Boldtkai/ECE411_Team6_Practicum/Enclosure Files/Printed_Lid_Top.jpg

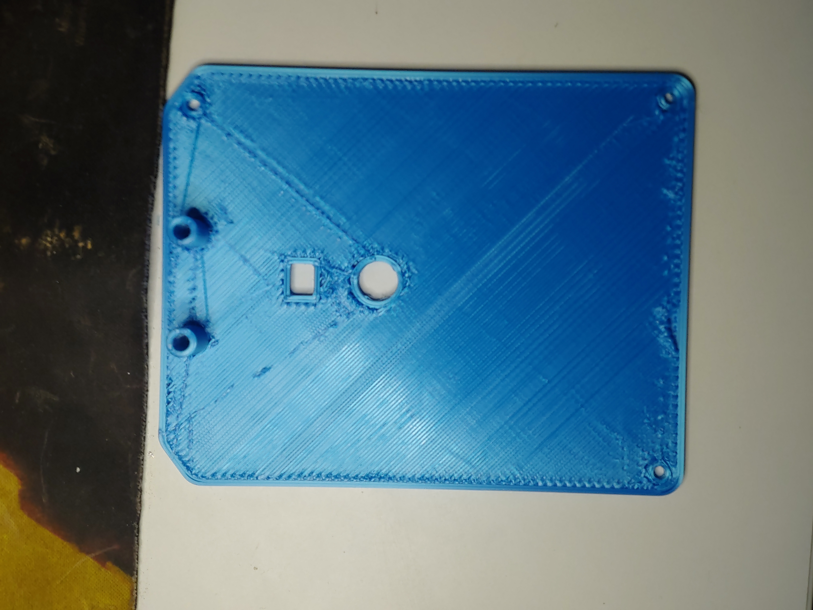
Enclosure Files/Printed_Lid_Top.jpg
