Boldtkai/ECE411_Team6_Practicum/Enclosure Files/Printed_Enclosure.jpg

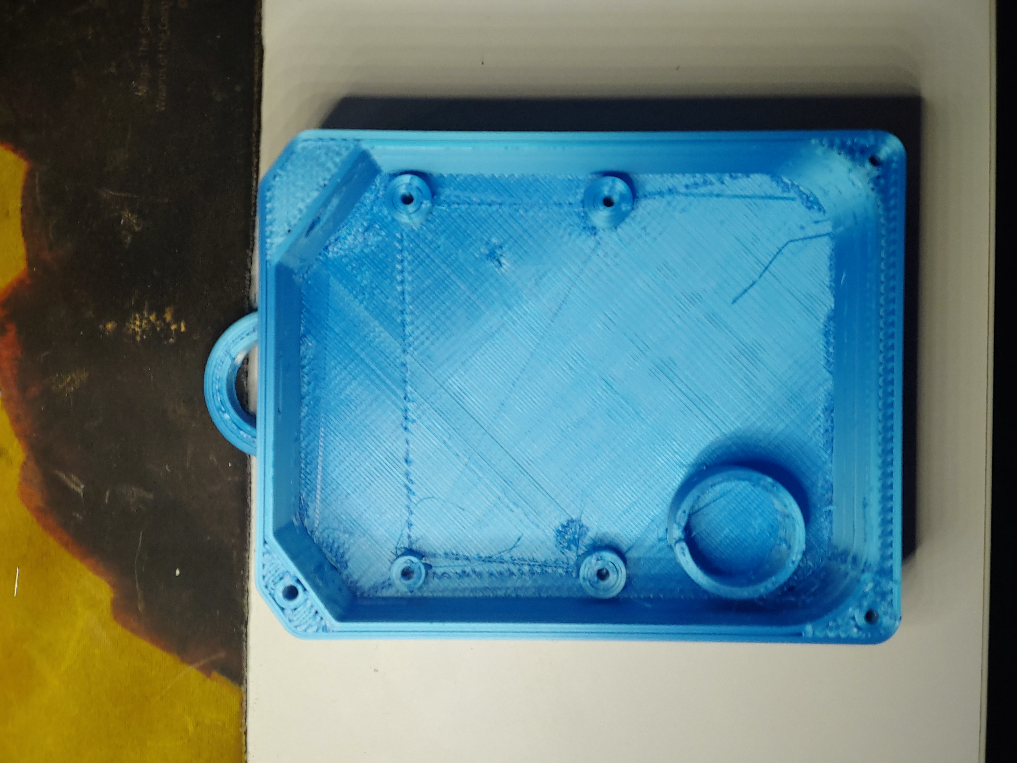
Enclosure Files/Printed_Enclosure.jpg
