Boldtkai/ECE411_Team6_Practicum/Bread Board Prototype/Audio_Amplifier_-_SD_Card_Module.jpg

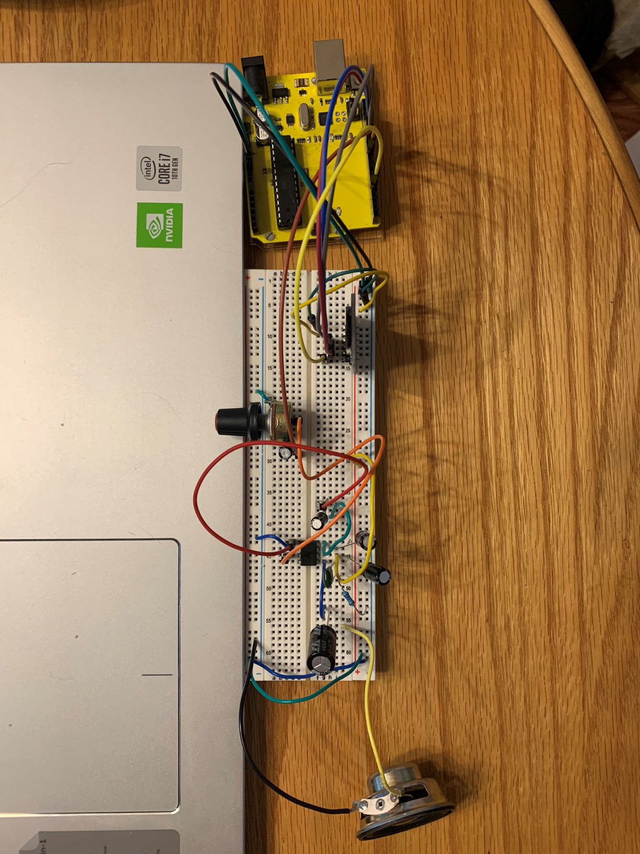
Bread Board Prototype/Audio_Amplifier_-_SD_Card_Module.jpg
