Boldtkai/ECE411_Team6_Practicum/Bread Board Prototype/FInalized Prototype.jpg

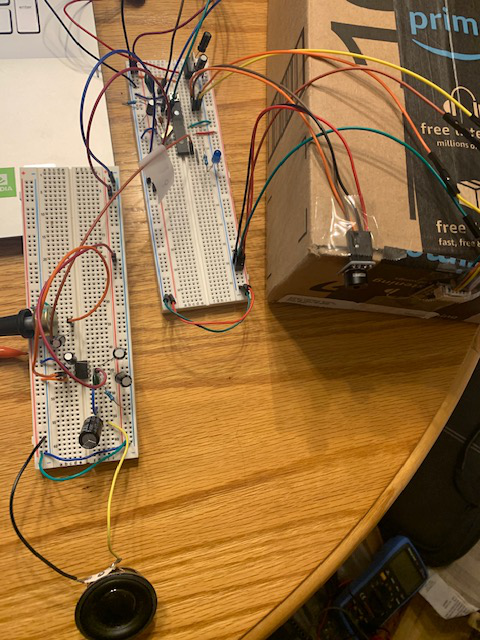
Bread Board Prototype/FInalized Prototype.jpg
