Boldtkai/ECE411_Team6_Practicum/Bread Board Prototype/Input_Sensors.jpg

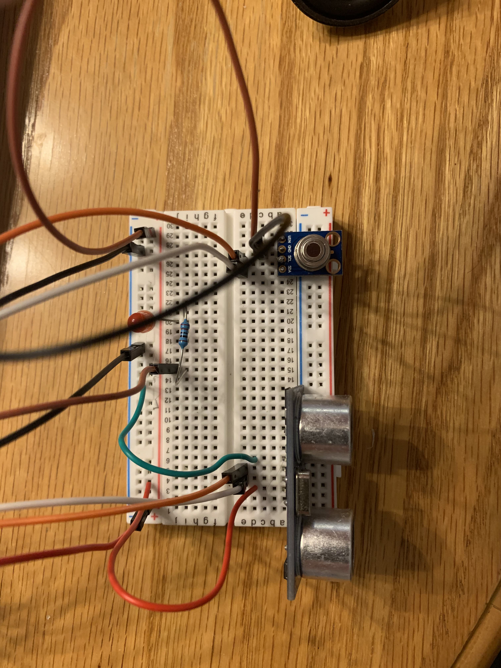
Bread Board Prototype/Input_Sensors.jpg
