Boldtkai/ECE411_Team6_Practicum/Bread Board Prototype/TOF and IR Temperature Sensor.jpg

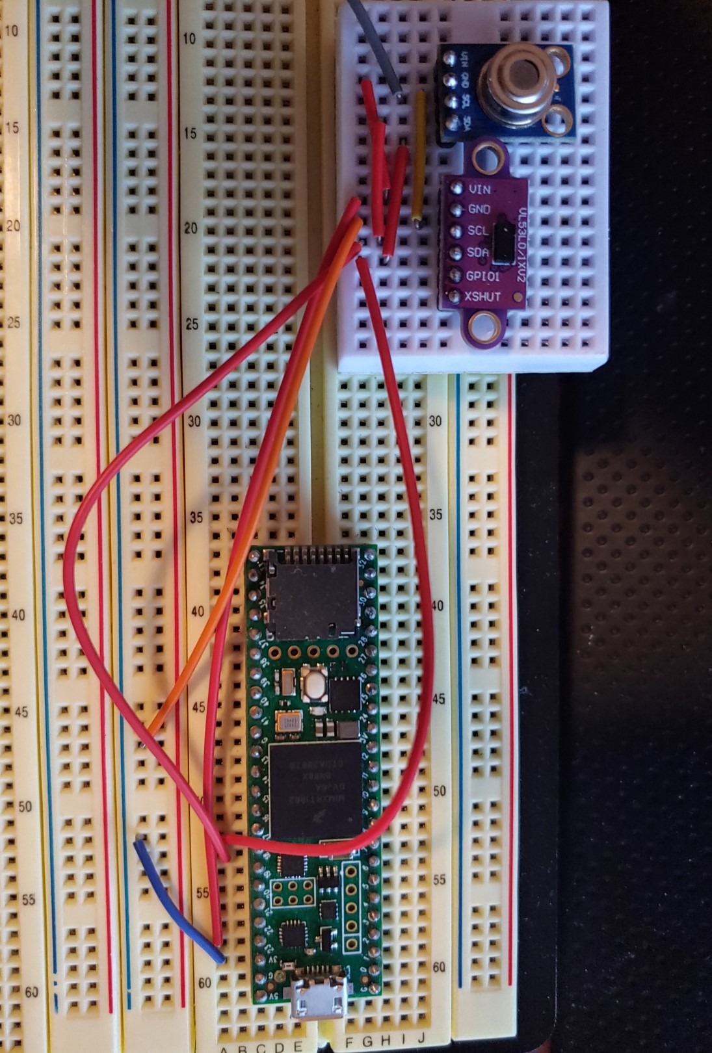
Bread Board Prototype/TOF and IR Temperature Sensor.jpg
