Boldtkai/ECE411_Team6_Practicum/Enclosure Files/Full Enclosure.png

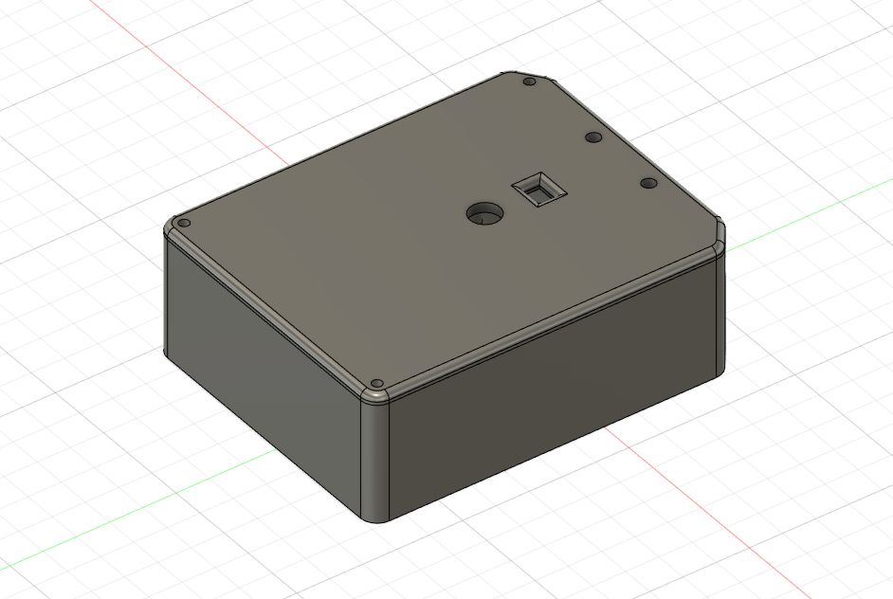
Enclosure Files/Full Enclosure.png
