Boldtkai/ECE411_Team6_Practicum/Enclosure Files/Just box.png

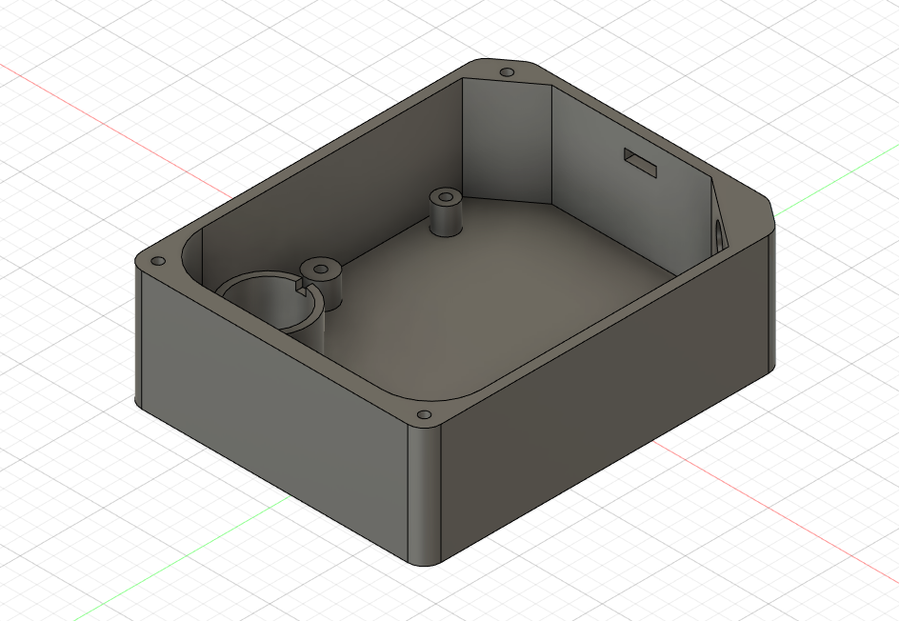
Enclosure Files/Just box.png
