Boldtkai/ECE411_Team6_Practicum/Enclosure Files/Just lid.png

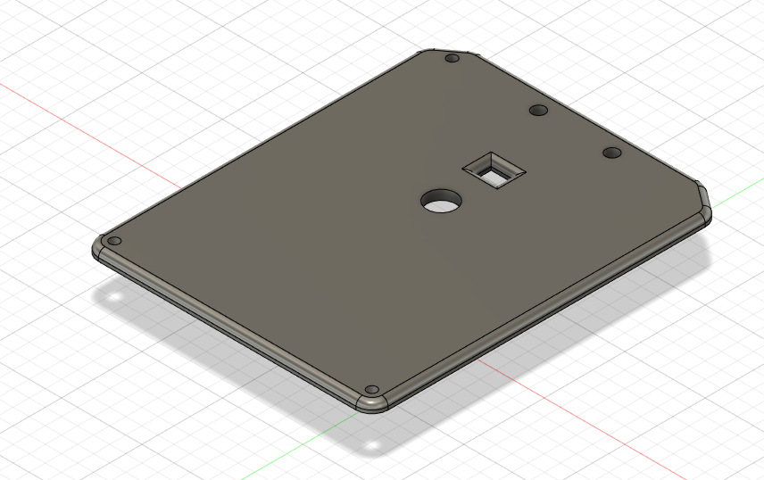
Enclosure Files/Just lid.png
