Boldtkai/ECE411_Team6_Practicum/Enclosure Files/Topdown_box.png

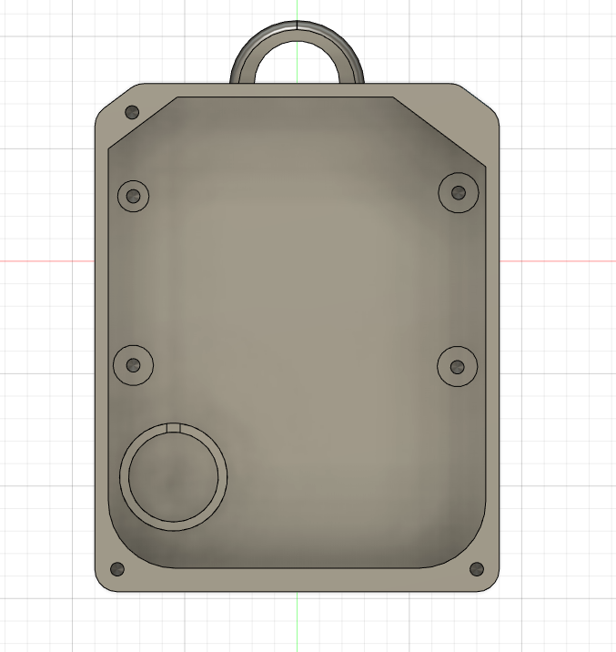
Enclosure Files/Topdown_box.png
