Boldtkai/ECE411_Team6_Practicum/Final Schematic and Layout/ECE411 Final Board Layout.PNG

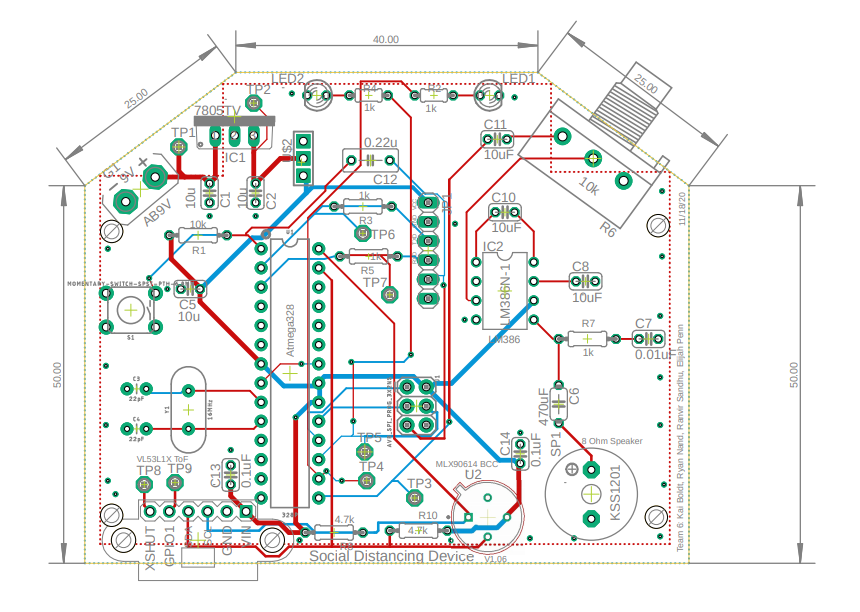
Final Schematic and Layout/ECE411 Final Board Layout.PNG
