Boldtkai/ECE411_Team6_Practicum/Final Schematic and Layout/OSHpark_PCB.jpg

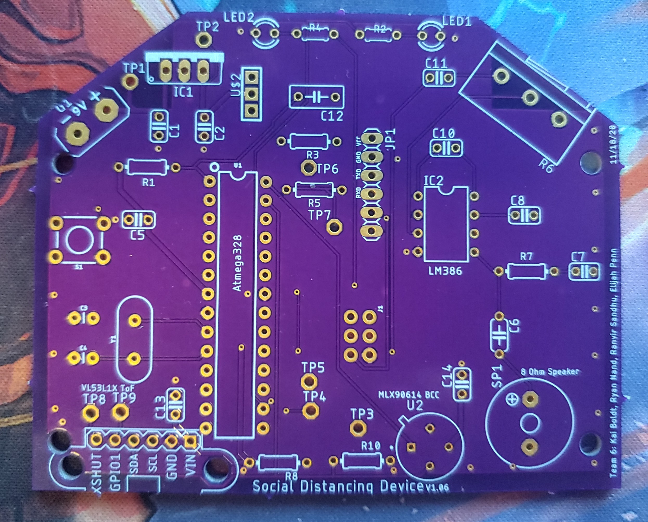
Final Schematic and Layout/OSHpark_PCB.jpg
