Boldtkai/ECE411_Team6_Practicum/Schematics/ECE411 Preliminary Schematic V1.01.png

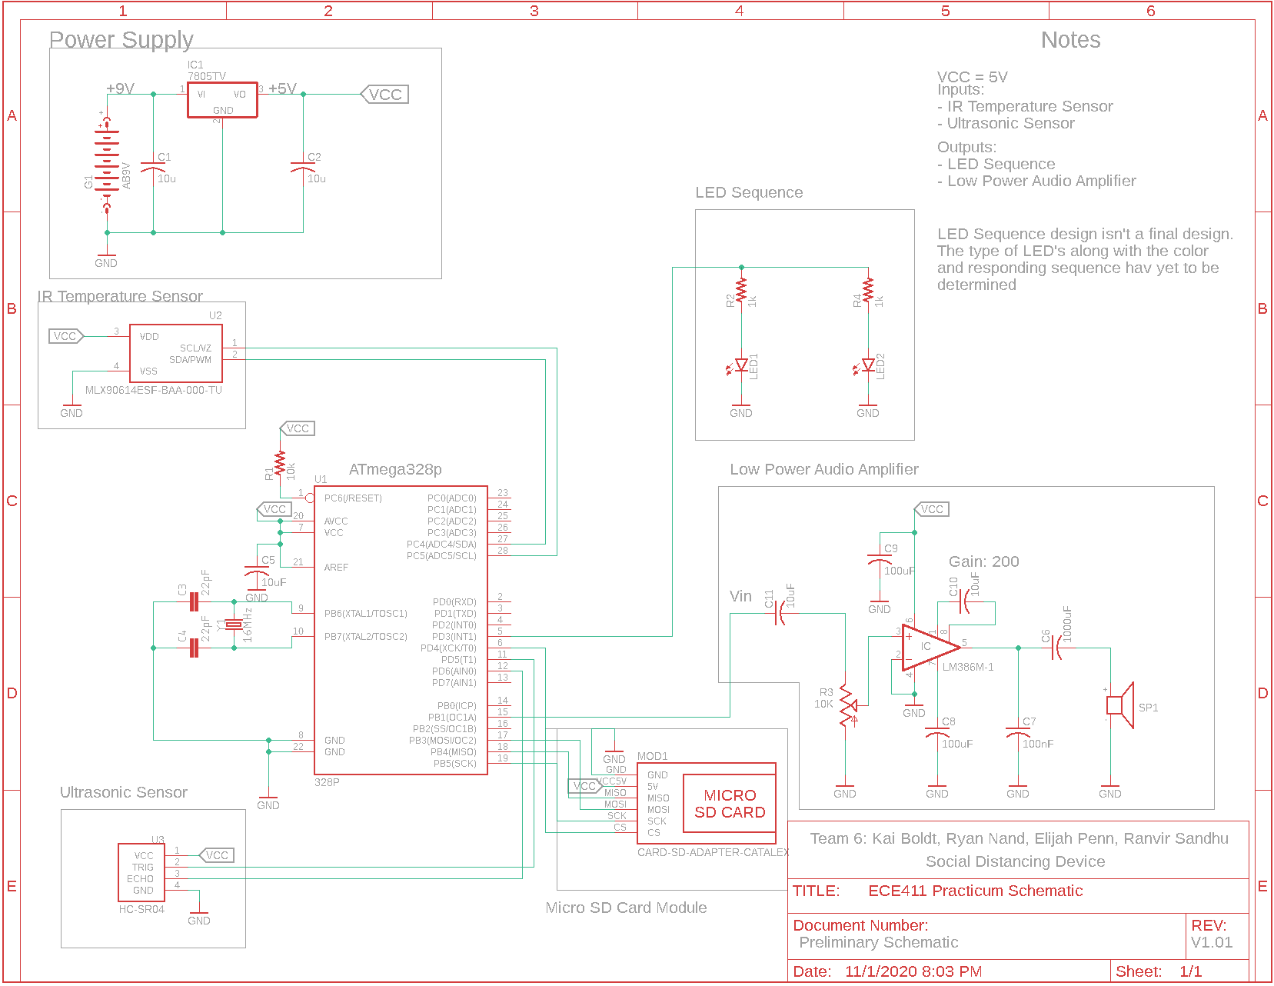
Schematics/ECE411 Preliminary Schematic V1.01.png
