Boldtkai/ECE411_Team6_Practicum/Bill of Materials/ECE411, Team6 - Bill of Materials (BoM).xlsx

Bill of Materials |  | Team 6: Kai Boldt, Ryan Nand, Ranvir Sandhu, Elijah Penn
Generated 11/10/2020
Modified 11/11/2020
Cnt | Value | Refs | Rev | Manufacturer | Mfr.Part Number | Description | Vendor | Vendor-PN | Price($)
2 |  | LED1, LED2 | 1.1 | Lite-On Inc. | LTL-1CHEE | 3mm LED RED CLEAR T/H | Digikey | 160-1704-ND | 0.32
1 | 10KΩ | R6 | 1.1 | TT Electronics | P164K101PNN20B103 | 17mm ROTARY POTENTIOMETER | Digikey | 987-P164K101PNN20B103-N | 1.14
1 | 10KΩ | R1 |  | Xicon | 283-10K-RC | RES 10K OHM 5% AXIAL | Digikey | 2197-283-10K-RC-ND | 0.6
4 | 1KΩ | R2,R3,R4,R5 |  | Xicon | 283-1K-RC | RES 1K OHM 5% AXIAL | Digikey | 2197-283-1K-RC-ND | 0.26
1 | 16MHz | Y1 |  | TXC CORPORATION | 9B-10.000MBBK-B | CRYSTAL 10.0000MHZ 20PF TH | Digikey | 9B-10.000MBBK-B | 0.3
1 | 32kb | U1 |  | Microchip Technology/Atmel | ATMEGA328P-PU | 8-bit Microcontrollers - MCU 32KB In-system Flash 20MHz 1.8V-5.5V | Mouser | 556-ATMEGA328P-PU | 2.08
1 |  | IC1 |  | Texas Instrument | LM7805CT/NOPB | IC REG LINEAR 5V 1A TO220-3 | Digikey | 296-47192-ND | 1.54
1 | 8Ω | SP1 | 1.1 | Kingstate | KSS-1201-16 | MAGNETIC TRANSDUCER
1 |  | IC | 1.1 | Texas Instrument | LM386N-1/NOPB | IC AMP CLASS AB MONO 325mW 8DIP | Digikey | 296-44414-5-ND | 1.17
1 |  | U2 |  | Melexis Technologies NV | MLX90614 BCC | SENSOR DGTL -40C-85C TO39 | Digikey | MLX90614ESF-BCC-000-TU-ND | 24.58
1 |  | U3 | 1.1 | YRCHENGLI | B08KS2X15K | VL53L1X Laser Ranging Flight Time Sensor Module | Amazon |  | 16.19
1 | 9V | G1 |  | Energizer Battery Company | EN22 | 9V Battery Non-Rechargeable | Digikey | N145-ND | 2.13
1 | 1000 µF | C6 |  | Illinois Capacitor | 108CKE025M | CAP ALUM 1000UF 20% 25V RADIAL | Digikey | 1572-1054-ND | 0.73
1 | 0.1 µF | C7 |  | TDK | FG26C0G2A104JRT06 | Multilayer Ceramic Capacitor 100V 0.1uF LS:5mm | Mouser | 810-FG26C0G2A104JRT6 | 1.06
2 | 100 µF | C8,C9 |  | Illinois Capacitor | 107CKE025MEM | CAP ALUM 100UF 20% 25V RADIAL | Digikey | 1572-1039-ND | 0.25
2 | 10 µF | C1,C2 |  | Illinois Capacitor | 106CKH050M | CAP ALUM 10UF 20% 50V THRU HOLE | Digikey | 1572-1284-ND | 0.21
2 | 10 µF | C10,C11 |  | Illinois Crapacito | 106BPS050M | CAP ALUM 10UF 20% 50V RADIAL | Digikey | 1572-1645-ND | 0.31
1 | 10 µF | C5 |  | Illinois Capacitor | ESH106M050AC3AA | CAP ALUM 10UF 20% 50V RADIAL | Digikey | 399-6543-ND | 0.18
2 | 22pF | C3,C4 |  | KEMET | C315C220K2G5TA7301 | CAP CER 22PF 200V C0G/NP0 RADIAL | Digikey | 399-13930-2-ND | 0.31
1 |  |  | 1.1 | HiLetgo | 3-01-0038-5PCS | Micro SD Card Adapter Module 6Pin, SPI Interface Driver Module | Amazon |  | 1.4
1 |  |  | 1.1 | DSD Tech | B07BBPX8B8 | USB to TTL Serial Adapter with FTDI FT232RL Chip | Amazon |  | 9.99
1 | 8Ω | SP1 | 1.1 | Uxcell | a15080600ux0275 | Metal Shell Round Speaker 2W 8 Ohm | Amazon |  | 2.37
NOTES
 | 1. Rev = The current Revision #
2. For Small Components (Resistors and Capacitors) are similar in values to the ones used in project
