Boldtkai/ECE411_Team6_Practicum/Bill of Materials/Bill of Matierials (BoM) V1.02.PNG

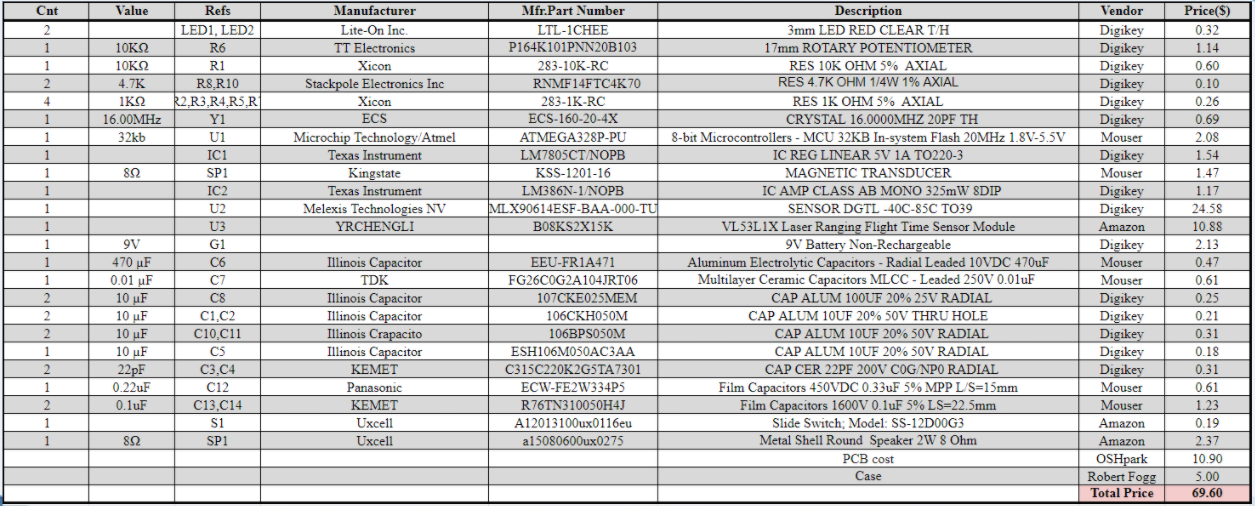
Bill of Materials/Bill of Matierials (BoM) V1.02.PNG
