Boldtkai/ECE411_Team6_Practicum/Enclosure Files/lid.stl

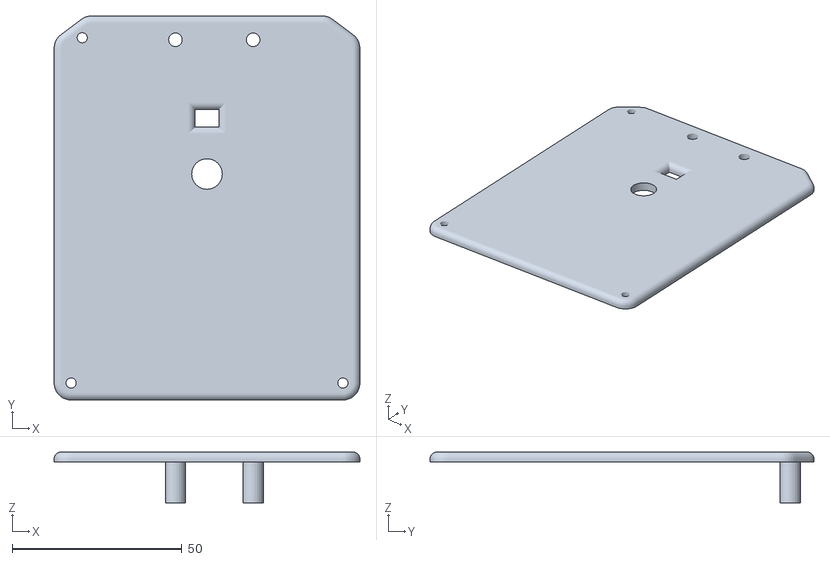
[picture p27: CAD file, 2020-12-05]
Enclosure Files/lid.stl
90.0 x 113.0 x 15.0
