Boldtkai/ECE411_Team6_Practicum/Enclosure Files/Enclosure.stl

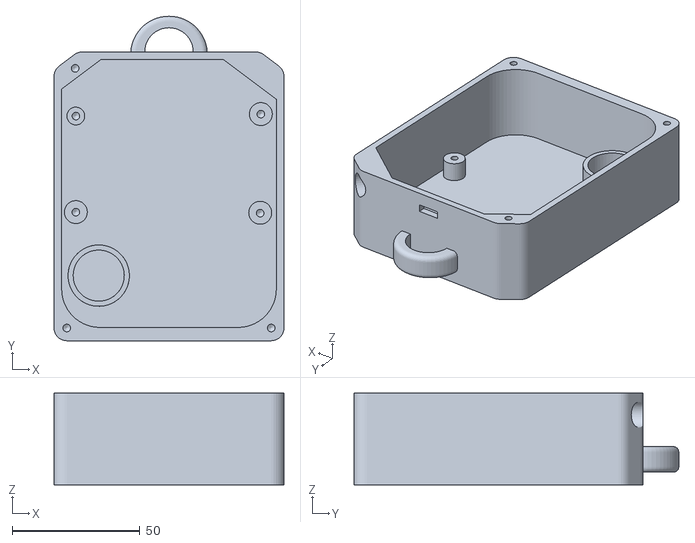
[picture p28: CAD file, 2020-12-05]
Enclosure Files/Enclosure.stl
90.0 x 127.0 x 36.0
