Boldtkai/ECE411_Team6_Practicum/Enclosure Files/Printed_Lid_Bottom.jpg

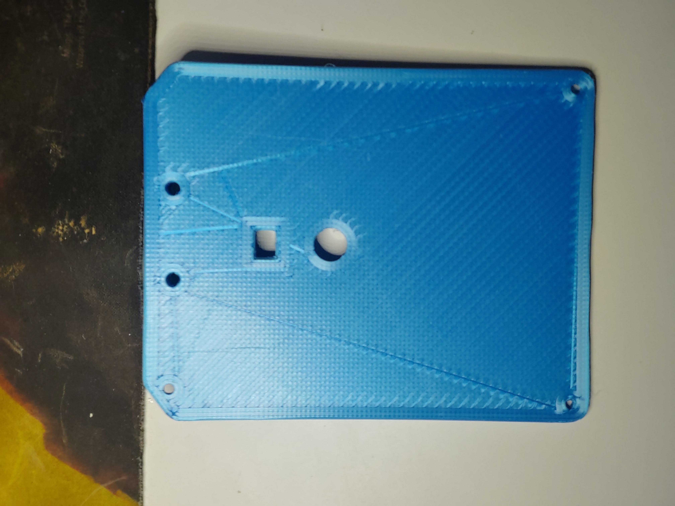
Enclosure Files/Printed_Lid_Bottom.jpg
