Boldtkai/ECE411_Team6_Practicum/(threads)

Thread 2 (2020-11-01):

ESP-NOW:

GenPen, 2020-11-01:
Will test with ESP-now protocol to connect two ESP32 breakout boards in order to have them communicate with each.  The protocol may be used track distance between the two ESP32 breakout boards as an alteranitve to our current set up using an IR and ultrasonic sensor to detect a person.

GenPen, 2020-11-05:
ESP-now can be used to have up to 10 esp32 chips communicate with each other without the need for a wifi network. This could useful if we decide to go with a closed system where the social distances sensors talk to each or instead of sensing the person wearing the device. This could be useful for a potential contact tracing feature later down the line. Using ESP-now to explicitly measure distance will not work.

Closed 2020-12-06.
