Boldtkai/ECE411_Team6_Practicum/Schematics/ECE411 Rough Draft Board Diagram.pdf

# Social Distancing Device

# 10uF 1000uF

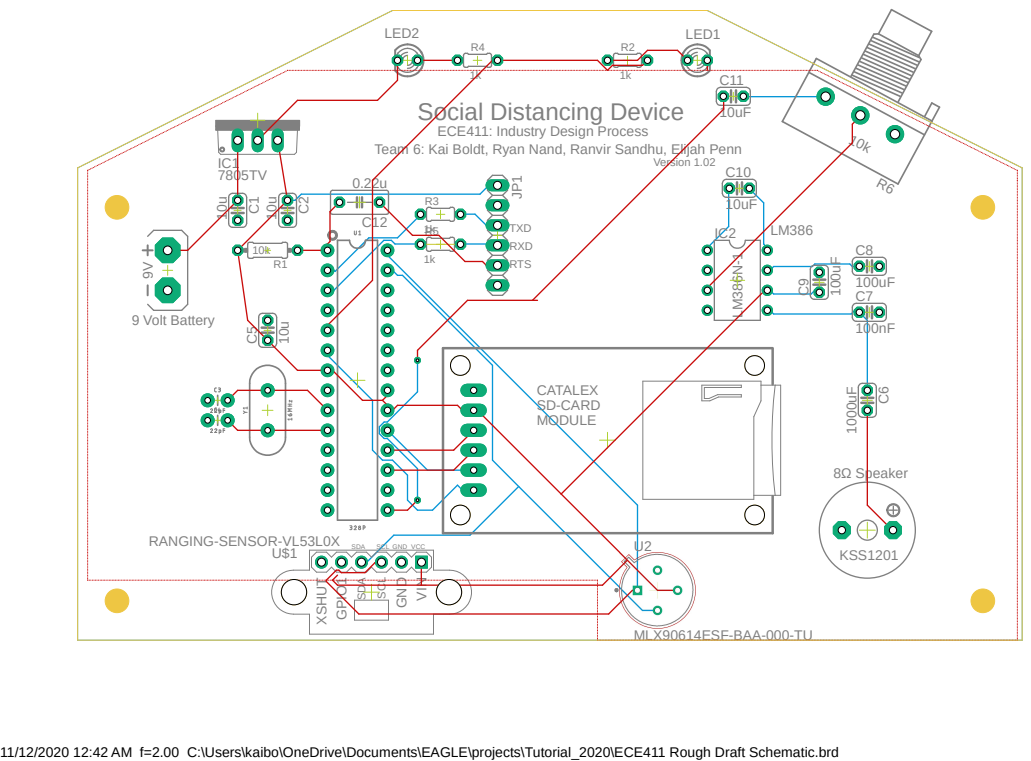
[picture p30: page 1]

Team 6: Kai Boldt, Ryan Nand, Ranvir Sandhu, Elijah Penn

11/12/2020 12:42 AM f=2.00 C:\Users\kaibo\OneDrive\Documents\EAGLE\projects\Tutorial_2020\ECE411 Rough Draft Schematic.brd
