Boldtkai/ECE411_Team6_Practicum/Schematics/ECE411 Rough Draft Schematic Diagram.pdf

## Power Supply

## Notes

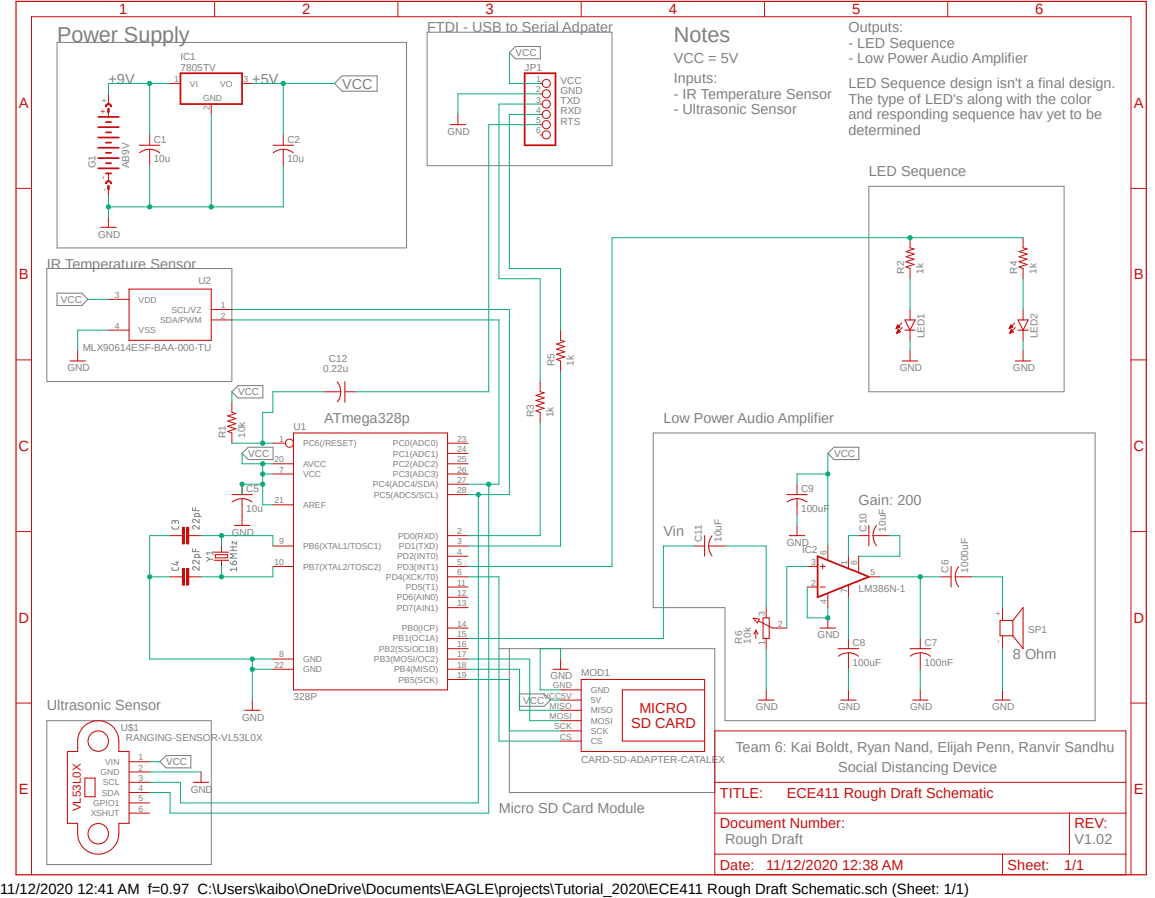
[picture p31: page 1]

FTDI - USB to Serial Adpater

Outputs:
- LED Sequence
- Low Power Audio Amplifier
LED Sequence design isn't a final design.
The type of LED's along with the color
and responding sequence hav yet to be
determined

Low Power Audio Amplifier

Team 6: Kai Boldt, Ryan Nand, Elijah Penn, Ranvir Sandhu

CARD-SD-ADAPTER-CATALEX

Micro SD Card Module

Document Number: | REV:

Date: 11/12/2020 12:38 AM | Sheet: 1/1

11/12/2020 12:41 AM f=0.97 C:\Users\kaibo\OneDrive\Documents\EAGLE\projects\Tutorial_2020\ECE411 Rough Draft Schematic.sch (Sheet: 1/1)
