Boldtkai/ECE411_Team6_Practicum/Schematics/ECE411, Team 6 Preliminary Layout.pdf

# Social Distancing Device

# C11 C⁶

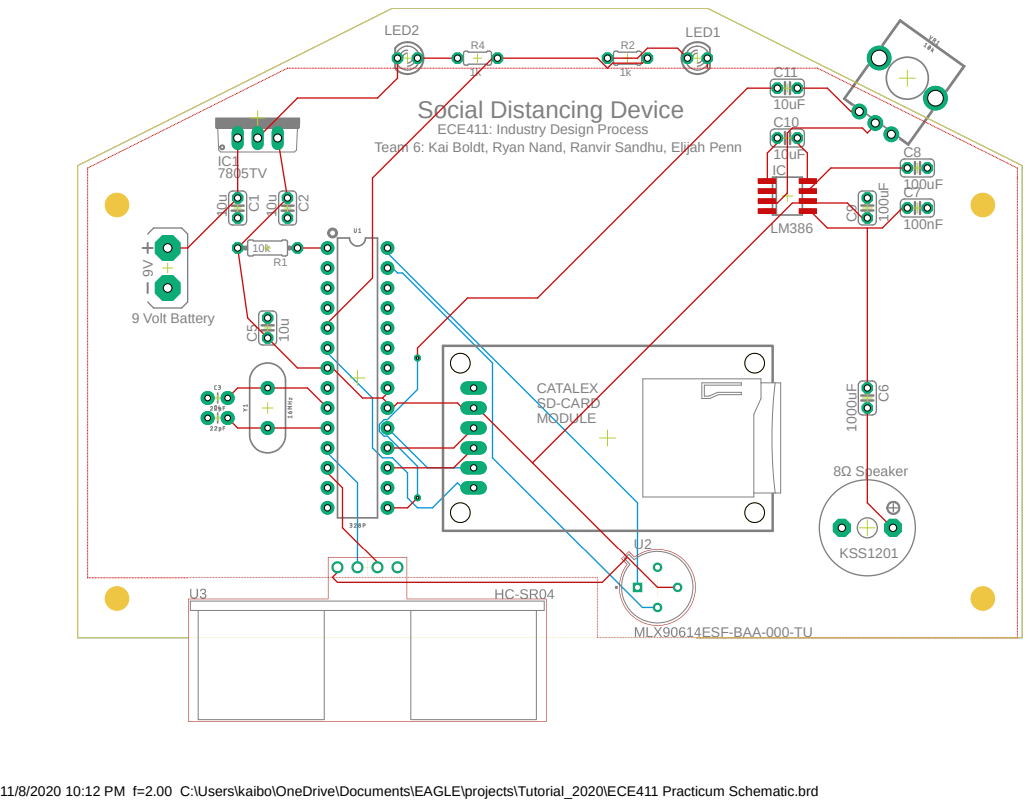
[picture p32: page 1]

Team 6: Kai Boldt, Ryan Nand, Ranvir Sandhu, Elijah Penn

11/8/2020 10:12 PM f=2.00 C:\Users\kaibo\OneDrive\Documents\EAGLE\projects\Tutorial_2020\ECE411 Practicum Schematic.brd
