Boldtkai/ECE411_Team6_Practicum/Final Schematic and Layout/ECE411 V1.06 Final Draft OshPark.brd

## EAGLE design Final Schematic and Layout/ECE411 V1.06 Final Draft OshPark.brd (2020-11-19)

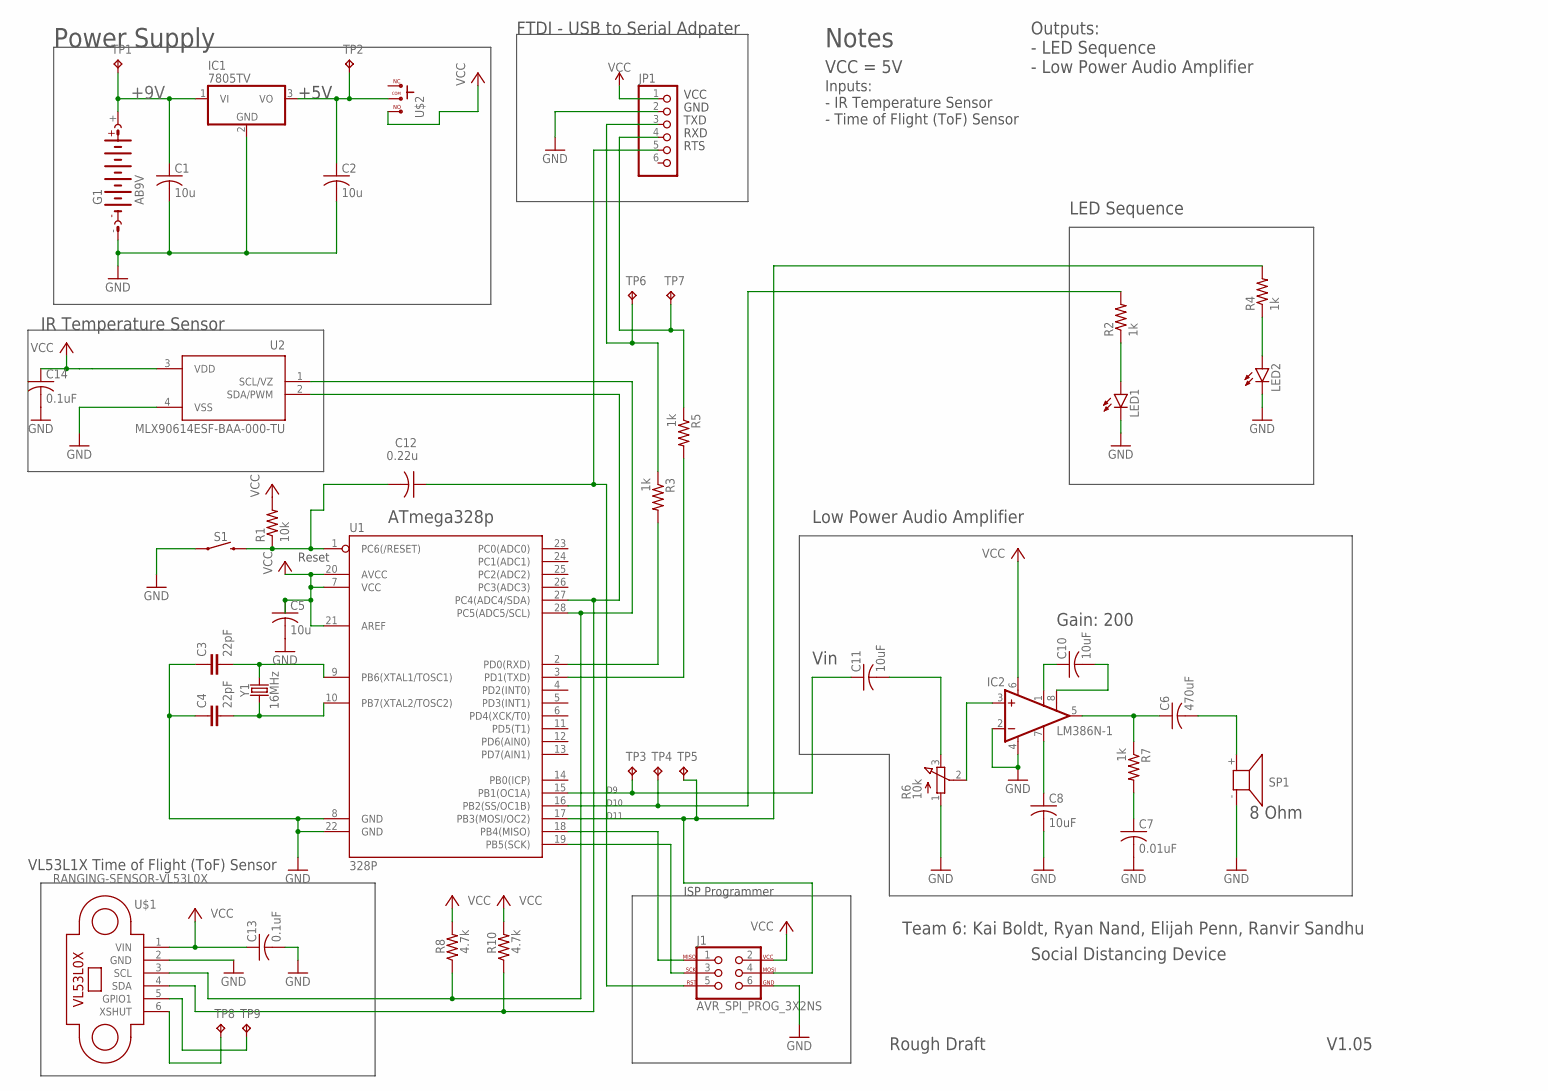
[picture p33: schematic ECE411 V1.06 Final Draft OshPark.sch]

Parts:
C1, C2, C5: 10u; C025-024X044
C3, C4: 22pF; CAP-PTH-2.54
C6: 470uF; C050-024X044
C7: 0.01uF; C025-024X044
C8, C10, C11: 10uF; C025-024X044
C12: 0.22u; C050-030X075
C13, C14: 0.1uF; C025-024X044
G1: AB9V
IC1: 7805TV; TO220V
IC2: LM386N-1; DIL08
J1: AVR_SPI_PROG_3X2NS; 2X3-NS
JP1: PINHD-1X6; 1X06
LED1, LED2: LED3MM
R1: 10k; 0204/7
R2, R4: 1k; 0204/5
R3, R5, R7: 1k; 0204/7
R6: 10k; 3RP/1610N
R8, R10: 4.7k; 0204/7
S1: MOMENTARY-SWITCH-SPST-PTH-6.0MM; TACTILE_SWITCH_PTH_6.0MM
SP1: KSS1201
TP1, TP2, TP3, TP4, TP5, TP6, TP7, TP8, TP9: TPPAD1-13; P1-13
U1: 328P; DIP28
U2: MLX90614ESF-BAA-000-TU; TO254P942H425-4
U$1: RANGING-SENSOR-VL53L0X
U$2: -SLIDERS; CON3
Y1: 16MHz; HC49US

Connections:
5V: C2.1, IC1.3 (VO), TP2.TP, U$2.P$2 (2)
+9V: C1.1, G1.+, IC1.1 (VI), TP1.TP
AUDIO: C11.1, TP3.TP, U1.15 (PB1(OC1A))
BYPASS: C8.1, IC2.7 (BYPASS)
GAIN: C10.1, IC2.1 (GAIN)
GND: C1.2, C2.2, C3.1, C4.1, C5.2, C7.2, C8.2, C13.2, C14.2, G1.-, IC1.2 (GND), IC2.2 (-IN), IC2.4 (GND), J1.6, JP1.2, LED1.K (C), LED2.K (C), R6.1 (A), S1.1, SP1.- (2), U1.8 (GND), U1.22 (GND), U2.4 (VSS), U$1.2 (GND)
GPIO1: TP9.TP, U$1.5 (GPIO1)
INPUT: IC2.3 (+IN), R6.2 (S)
LED1: R2.2, TP4.TP, U1.16 (PB2(SS/OC1B))
LED2: J1.4, R4.2, TP5.TP, U1.17 (PB3(MOSI/OC2))
unnamed: C3.2, U1.9 (PB6(XTAL1/TOSC1)), Y1.2
unnamed: J1.1, U1.18 (PB4(MISO))
unnamed: C4.2, U1.10 (PB7(XTAL2/TOSC2)), Y1.1
unnamed: TP8.TP, U$1.6 (XSHUT)
unnamed: J1.3, U1.19 (PB5(SCK))
unnamed: C7.1, R7.2
unnamed: C10.2, IC2.8 (GAIN)
unnamed: C11.2, R6.3 (E)
unnamed: LED1.A, R2.1
unnamed: LED2.A, R4.1
RESET: C12.2, R1.1, S1.3 (2), U1.1 (PC6(/RESET))
RTS: C12.1, J1.5, JP1.5
RXD: JP1.4, R5.1, R5.2, TP7.TP, U1.3 (PD1(TXD))
SCL: R8.1, U1.28 (PC5(ADC5/SCL)), U2.1 (SCL/VZ), U$1.3 (SCL)
SDA: R10.1, U1.27 (PC4(ADC4/SDA)), U2.2 (SDA/PWM), U$1.4 (SDA)
TXD: JP1.3, R3.1, R3.2, TP6.TP, U1.2 (PD0(RXD))
VCC: C5.1, C13.1, C14.1, IC2.6 (VS), J1.2, JP1.1, R1.2, R8.2, R10.2, U1.7 (VCC), U1.20 (AVCC), U1.21 (AREF), U2.3 (VDD), U$1.1 (VIN), U$2.P$3 (3)
VO: C6.2, SP1.+ (1)
VOUT: C6.1, IC2.5 (OUT), R7.1

Notes on the sheet:
+5V
Power Supply
IR Temperature Sensor
Low Power Audio Amplifier
LED Sequence
Team 6: Kai Boldt, Ryan Nand, Elijah Penn, Ranvir Sandhu
Gain: 200
ATmega328p
Social Distancing Device
Notes
VCC = 5V
Outputs: - LED Sequence - Low Power Audio Amplifier
Vin
8 Ohm
VCC
GND
TXD
RXD
RTS
FTDI - USB to Serial Adpater
Rough Draft
Reset
V1.05
VL53L1X Time of Flight (ToF) Sensor
Inputs: - IR Temperature Sensor - Time of Flight (ToF) Sensor
D10
D11
ISP Programmer

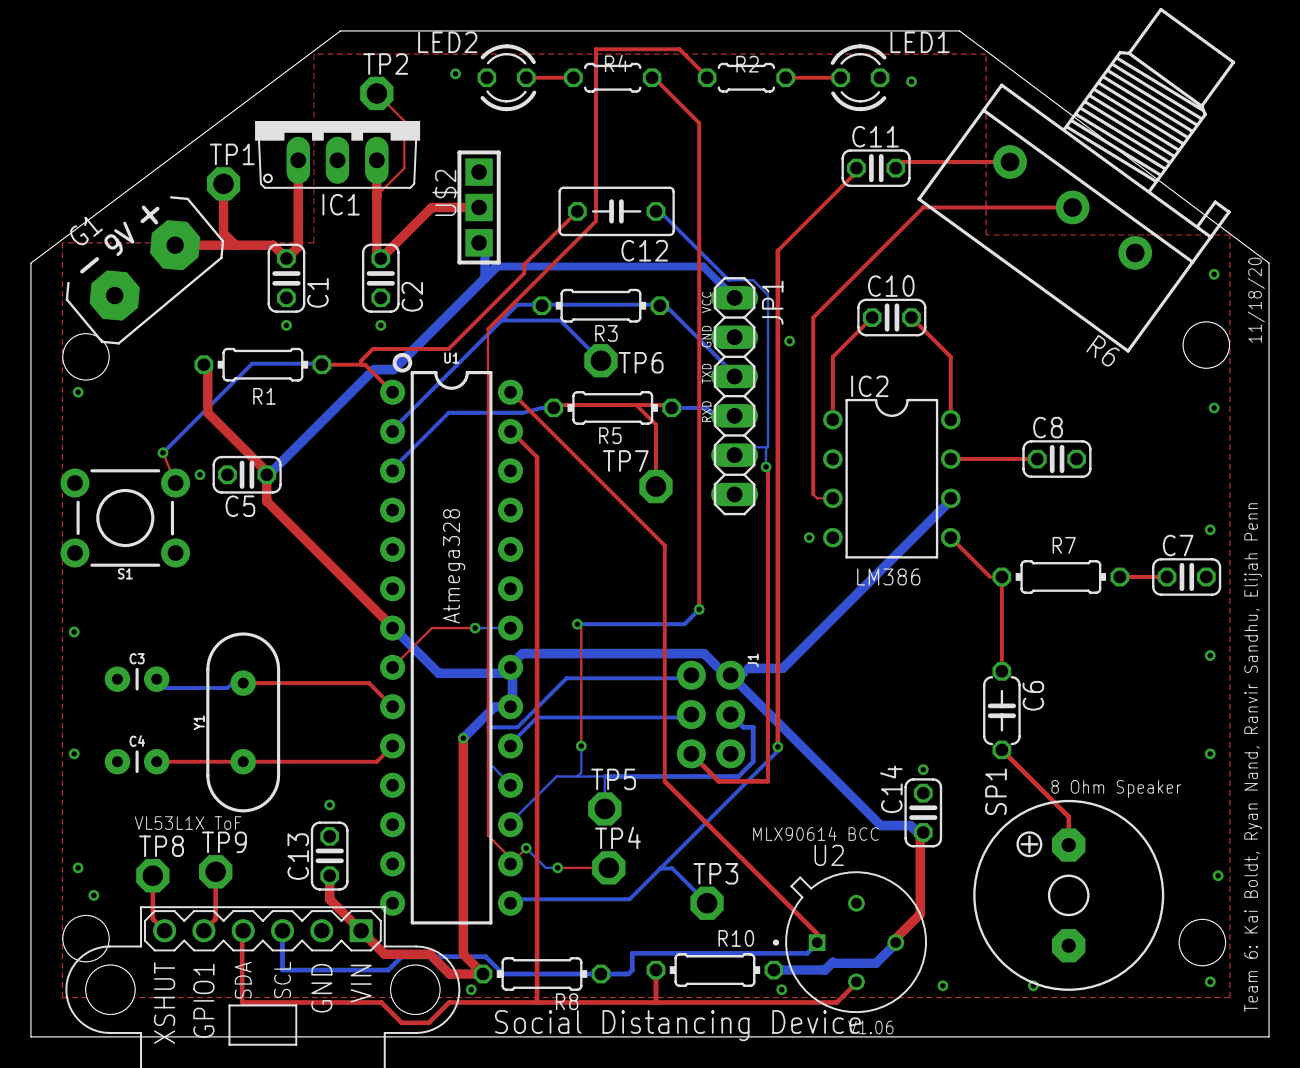
[picture p34: board ECE411 V1.06 Final Draft OshPark.brd from above]

Board: 2 copper layers, 80.0 x 65.0 mm, 45 parts (0 on the bottom side), 29 nets.
