Boldtkai/ECE411_Team6_Practicum/Schematics/ECE411 Rough Draft Schematic.brd

## EAGLE design Schematics/ECE411 Rough Draft Schematic.brd (2020-11-12)

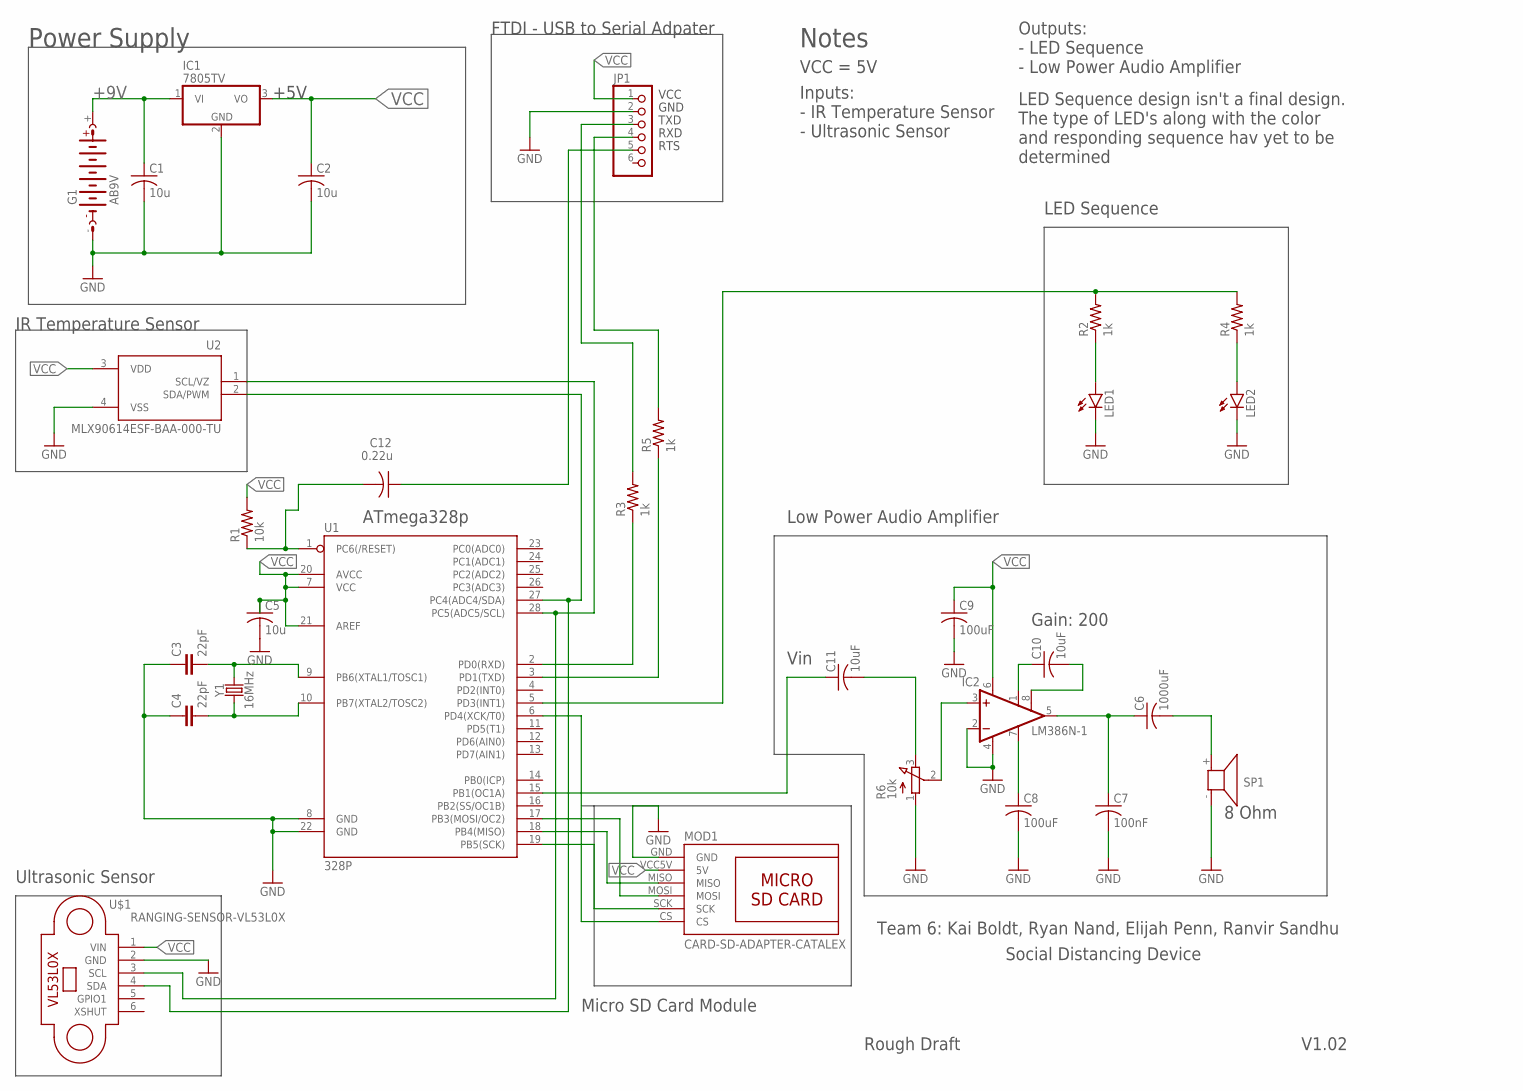
[picture p35: schematic ECE411 Rough Draft Schematic.sch]

Parts:
C1, C2, C5: 10u; C025-024X044
C3, C4: 22pF; CAP-PTH-2.54
C6: 1000uF; C025-024X044
C7: 100nF; C025-024X044
C8, C9: 100uF; C025-024X044
C10, C11: 10uF; C025-024X044
C12: 0.22u; C050-030X075
G1: AB9V
IC1: 7805TV; TO220V
IC2: LM386N-1; DIL08
JP1: PINHD-1X6; 1X06
LED1, LED2: LED3MM
MOD1: CARD-SD-ADAPTER-CATALEX
R1: 10k; 0204/7
R2, R3, R4, R5: 1k; 0204/5
R6: 10k; 3RP/1610N
SP1: KSS1201
U1: 328P; DIP28
U2: MLX90614ESF-BAA-000-TU; TO254P942H425-4
U$1: RANGING-SENSOR-VL53L0X
Y1: 16MHz; HC49US

Connections:
+9V: C1.1, G1.+, IC1.1 (VI)
CS: MOD1.CS, U1.6 (PD4(XCK/T0))
GND: C1.2, C2.2, C3.1, C4.1, C5.2, C7.2, C8.2, C9.2, G1.-, IC1.2 (GND), IC2.2 (-IN), IC2.4 (GND), JP1.2, LED1.K (C), LED2.K (C), MOD1.GND, R6.1 (A), SP1.- (2), U1.8 (GND), U1.22 (GND), U2.4 (VSS), U$1.2 (GND)
MISO: MOD1.MISO, U1.18 (PB4(MISO))
MOSI: MOD1.MOSI, U1.17 (PB3(MOSI/OC2))
unnamed: C3.2, U1.9 (PB6(XTAL1/TOSC1)), Y1.2
unnamed: C12.2, R1.1, U1.1 (PC6(/RESET))
unnamed: C4.2, U1.10 (PB7(XTAL2/TOSC2)), Y1.1
unnamed: C8.1, IC2.7 (BYPASS)
unnamed: C6.1, C7.1, IC2.5 (OUT)
unnamed: C10.2, IC2.8 (GAIN)
unnamed: IC2.3 (+IN), R6.2 (S)
unnamed: C10.1, IC2.1 (GAIN)
unnamed: C11.2, R6.3 (E)
unnamed: C11.1, U1.15 (PB1(OC1A))
unnamed: R2.2, R4.2, U1.5 (PD3(INT1))
unnamed: LED1.A, R2.1
unnamed: LED2.A, R4.1
unnamed: R3.1, U1.2 (PD0(RXD))
RTS: C12.1, JP1.5
RXD: JP1.4, R5.1, R5.2, U1.3 (PD1(TXD))
SCK: MOD1.SCK, U1.19 (PB5(SCK))
SCL: U1.28 (PC5(ADC5/SCL)), U2.1 (SCL/VZ), U$1.3 (SCL)
SDA: U1.27 (PC4(ADC4/SDA)), U2.2 (SDA/PWM), U$1.4 (SDA)
TXD: JP1.3, R3.2
VCC: C2.1, C5.1, C9.1, IC1.3 (VO), IC2.6 (VS), JP1.1, MOD1.VCC5V (5V), R1.2, U1.7 (VCC), U1.20 (AVCC), U1.21 (AREF), U2.3 (VDD), U$1.1 (VIN)
VO: C6.2, SP1.+ (1)

Notes on the sheet:
+5V
Power Supply
IR Temperature Sensor
Low Power Audio Amplifier
LED Sequence
Micro SD Card Module
Ultrasonic Sensor
Team 6: Kai Boldt, Ryan Nand, Elijah Penn, Ranvir Sandhu
Gain: 200
ATmega328p
Social Distancing Device
Notes
Inputs: - IR Temperature Sensor - Ultrasonic Sensor
VCC = 5V
Outputs: - LED Sequence - Low Power Audio Amplifier
LED Sequence design isn't a final design. The type of LED's along with the color and responding sequence hav yet to be determined
Vin
8 Ohm
VCC
GND
TXD
RXD
RTS
FTDI - USB to Serial Adpater
V1.02
Rough Draft

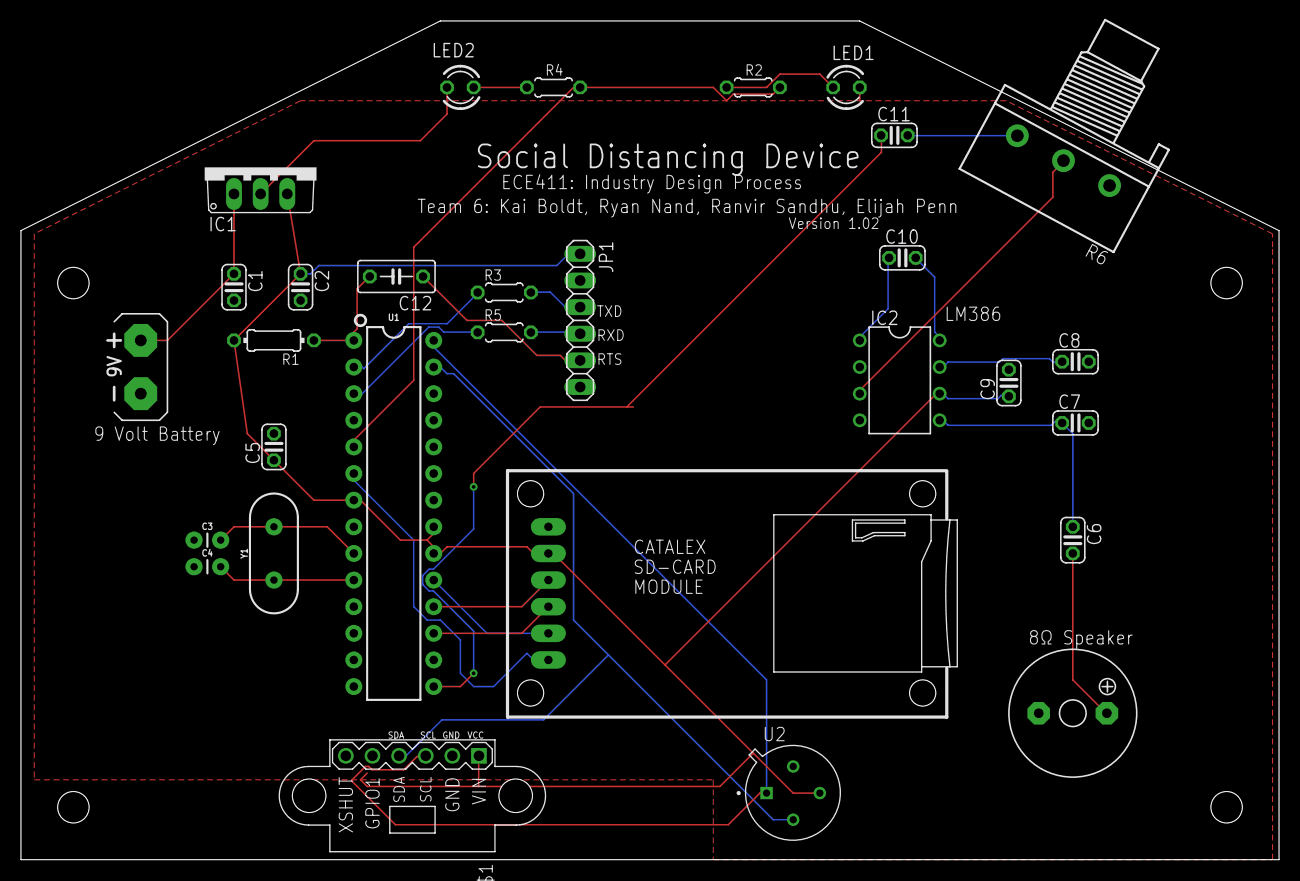
[picture p36: board ECE411 Rough Draft Schematic.brd from above]

Board: 2 copper layers, 120.0 x 80.0 mm, 30 parts (0 on the bottom side), 27 nets.
