Boldtkai/ECE411_Team6_Practicum/(commit log)

2020-11-01 Add files via upload
    ESP32 and TOF sensor Datasheets
2020-11-02 Create Preliminary Schematics
2020-11-02 Delete Input Sensors.HEIC
    Wrong Format
2020-11-02 Delete ECE411 Preliminary Schematic V1.01.png
    Has been updated
2020-11-04 SMT voltage regulator for 5V to 3.3V
2020-11-12 Create Bill of Materials
2020-11-12 Create Bill of Materials (BoM)
2020-11-18 Create Final Draft of Schematic and Layout
2020-12-05 Enclosure files for project
    [Enclosure.stl, lid.stl]
2020-12-05 Pictures of enclosure in Fusion 360
2020-12-06 3D Printed Parts
2020-12-07 Improvements/Fixes to Enclosure
2020-12-09 Extra Pictures of 3D Printed Enclosure
2020-12-09 Actual PCB
