Boldtkai/ECE411_Team6_Practicum/(notices)

Notices in the files:
parts and their libraries:
SparkFun-Clocks: Licensing: Creative Commons ShareAlike 4.0 International - https://creativecommons.org/licenses/by-sa/4.0
VL53L0X: Released under the Creative Commons Attribution 4.0 International License: http://creativecommons.org/licenses/by/4.0
